FrancisCrickInstitute/Cryopup/README.md

# Cryopup

A low-cost device for cryoanaesthesia of neonate rodents that can cool and warm up.

CryoPup_graphical_abstract
