FrancisCrickInstitute/Cryopup/Manufacturing files/Printed circuit board/BOM_PCB_2021-06-22_17-24-27_2022-03-15.csv

ID | Name | Designator | Footprint | Quantity | Manufacturer Part | Manufacturer | Supplier | Supplier Part | Price | Pins | JLCPCB Part Class | LCSC Assembly | Contributor | SMT Type
1 | 1K | R18,R1 | R0805 | 2 | 0805W8F1001T5E | UniOhm | LCSC | C17513 | 0.002 | 2 | Basic Part |  | layout
2 | 10K | R21,R12,R13,R16 | R0805 | 4 | 0805W8F1002T5E | UniOhm | LCSC | C17414 | 0.002 | 2 | Basic Part |  | layout
3 | LTV-817S-TA1-C | U2 | OPTO-SMD-4_L4.6-W6.5-P2.54-LS10.3-BL | 1 | LTV-817S-TA1-C | LITEON | LCSC | C109227 | 0.072 | 4 | Extended Part |  | LCSC
4 | CON_HEADER_1X02-PTH | J1,J2,J3,J4 | M1X2 | 4 |  |  |  |  |  | 2 |  |  | DangerousPrototype
5 | micro USBFemale | USB1 | MICRO-USB-SMD_5P-P0.65-H-F_C10418 | 1 | micro USBFemale | ValuePro | LCSC | C10418 | 0.071 | 9 | Extended Part |  | 立创EDA官方封装库
6 | IRFH8318TRPBF | Q5,Q7,Q8,Q1,Q2 | PQFN-8_L5.8-W4.9-P1.27-LS6.0-BL-1 | 5 | IRFH8318TRPBF | Infineon | LCSC | C82059 | 0.562 | 9 | Extended Part |  | LCSC
7 | 3.9K | R8,R14 | R0805 | 2 | 0805W8F3901T5E | UniOhm | LCSC | C17614 | 0.002 | 2 | Basic Part |  | layout
8 | 1.8K | R17,R19,R20,R11,R15 | R0805 | 5 | 0805W8F1801T5E | UniOhm | LCSC | C17398 | 0.003 | 2 | Basic Part |  | layout
9 | DC005-2.0MM | DC1 | DC-IN-TH_DC005 | 1 | DC005-2.0MM | SOFNG | LCSC | C111567 | 0.153 | 3 |  |  | LCSC
10 | JUMPER-3PTH | JP1 | 1X03 | 1 |  |  |  |  |  | 3 |  |  | SparkFun
11 | 0.96OLED_4P | OLED1 | 0.96OLED_4P | 1 |  |  | LCSC |  |  | 4 |  |  | LCEDA_Lib
12 | PEC11R-4220F-S0012 | SW3 | SW-TH_PEC11R-4220F-S0012 | 1 | PEC11R-4220F-S0012 | BOURNS | LCSC | C143817 | 2.01 | 7 |  |  | LCSC
13 | 100nF | C1,C3,C8,C15 | C0805 | 4 | CC0805KRX7R9BB104 | YAGEO | LCSC | C49678 | 0.005 | 2 | Basic Part |  | LCSC
14 | 10uF | C2,C12,C14 | C0805 | 3 | CL21A106KAYNNNE | SAMSUNG | LCSC | C15850 |  | 2 | Basic Part |  | LCSC
15 | 10uF | C9,C16 | CAP-SMD_BD6.3-L6.6-W6.6-FD | 2 | EEEHB1H100SP | PANASONIC | LCSC | C178618 | 0.308 | 2 | Extended Part |  | LCSC
16 | 1uF | C10,C11,C13 | C0805 | 3 | CL21B105KBFNNNE | SAMSUNG | LCSC | C28323 | 0.009 | 2 | Basic Part |  | LCSC
17 | 22K | R9 | R0805 | 1 | 0805W8F2202T5E | UniOhm | LCSC | C17560 | 0.003 | 2 | Basic Part |  | layout
18 | 150 | R10 | R0805 | 1 | 0805W8F1500T5E | UniOhm | LCSC | C17471 | 0.003 | 2 |  | Yes | layout | Basic
19 | KF129R-5.0-2P | FET1,FET2,TC1,TC2,HB | CONN-TH_P5.00_KF129R-5.0-2P | 5 | KF129R-5.0-2P | Cixi Kefa Elec | LCSC | C475098 | 0.211 | 2 |  |  | LCSC
20 | SMALL_SERVO | SM | 1X03 | 1 |  |  |  |  |  | 3 |  |  | SparkFun
21 | NUP2105LT1G | D3 | SOT-23-3_L2.9-W1.6-P1.90-LS2.8-BR | 1 | NUP2105LT1G | ON | LCSC | C14486 | 0.396 | 3 |  | Yes | jiaowoxiaolu | Extend
22 | TS-1187A-B-A-B | SW2 | SW-SMD_4P-L5.1-W5.1-P3.70-LS6.5-TL-2 | 1 | TS-1187A-B-A-B | XKB Enterprise | LCSC | C318884 | 0.016 | 4 | Extended Part |  | LCSC
23 | 2.2uH | L2,L1,L4,L3 | L0805 | 4 | AIML-0805HC-2R2M-T | Abracon LLC | LCSC | C193676 | 0.243 | 2 |  |  | LCSC
24 | 470nF | C6 | C0805 | 1 | CL21B474KBFNNNE | SAMSUNG | LCSC | C13967 | 0.015 | 2 |  | Yes |  | Basic
25 | NUP2105LT1G | D1,D2 | SOT-23-3_L2.9-W1.6-P1.90-LS2.8-BR | 2 | NUP2105LT1G | ON | LCSC | C14486 | 0.396 | 3 |  | Yes |  | Extend
26 | 150 | R3,R2,R5,R7,R6,R4 | R0805 | 6 | 0805W8F1500T5E | UniOhm | LCSC | C17471 | 0.003 | 2 |  | Yes |  | Basic
27 | MAX31855KASA+T | U4,U9 | SO-8_L4.9-W3.9-P1.27-LS5.9-BL | 2 | MAX31855KASA+T | MAXIM | LCSC | C52028 | 5.215 | 8 |  | Yes |  | Extend
28 | 10nF | C7,C4 | C0805 | 2 | CL21B103KBANNNC | SAMSUNG | LCSC | C1710 | 0.006 | 2 |  | Yes |  | Basic
29 | CP2104-F03-GM | U11 | QFN-24_L4.0-W4.0-P0.50-BL-EP2.7 | 1 | CP2104-F03-GM | SILICON LABS | LCSC | C47742 | 4.179 | 25 | Basic Part
30 | Rocker switch601-10211BB | SW1 | SW-TH_601-10211BB | 1 | Rocker switch601-10211BB | BBJ | LCSC | C67849 | 0.177 | 3
31 | LED-0805_R | LED1 | LED0805_RED | 1 | 17-21SURC/S530-A3/TR8 | EVERLIGHT(台湾亿光) |  | C72037 | 0.017 | 2 |  |  | LCEDA_Lib
32 | L9958XP | U1 | POWERSSO-24_L10.5-W7.6-P0.80-LS10.5-BL | 1 | L9958XP | STMicroelectronics | LCSC | C443848 | 6.933 | 25 | Extended Part |  | LCSC
33 | AP7365-33WG-7 | U12 | SOT-25_L3.0-W1.6-P0.95-LS2.8-BR | 1 | AP7365-33WG-7 | DIODES | LCSC | C150742 | 0.208 | 5 | Extended Part |  | LCSC
34 | MMBT2222A-G | Q3,Q4 | SOT-23-3_L2.9-W1.6-P1.90-LS2.8-BR | 2 | MMBT2222A-G | CJ | LCSC | C164898 | 0.024 | 3 | Extended Part |  | LCSC
35 | ESP32-WROOM-32D(16MB) | U5 | WIFIM-SMD_39P-L25.5-W18.0-P1.27-BL | 1 | ESP32-WROOM-32D(16MB) | Espressif Systems | LCSC | C529578 | 4.764 | 39 | Extended Part |  | LCSC
36 | MC7805BDTRKG | U3 | TO-252-2_L6.6-W6.1-P4.57-LS9.9-TL-CW | 1 | MC7805BDTRKG | ON | LCSC | C110908 | 0.425 | 3 | Extended Part |  | 官方封装库
