FrancisCrickInstitute/Cryopup/Design files/Mechanical parts/Face holder.STEP

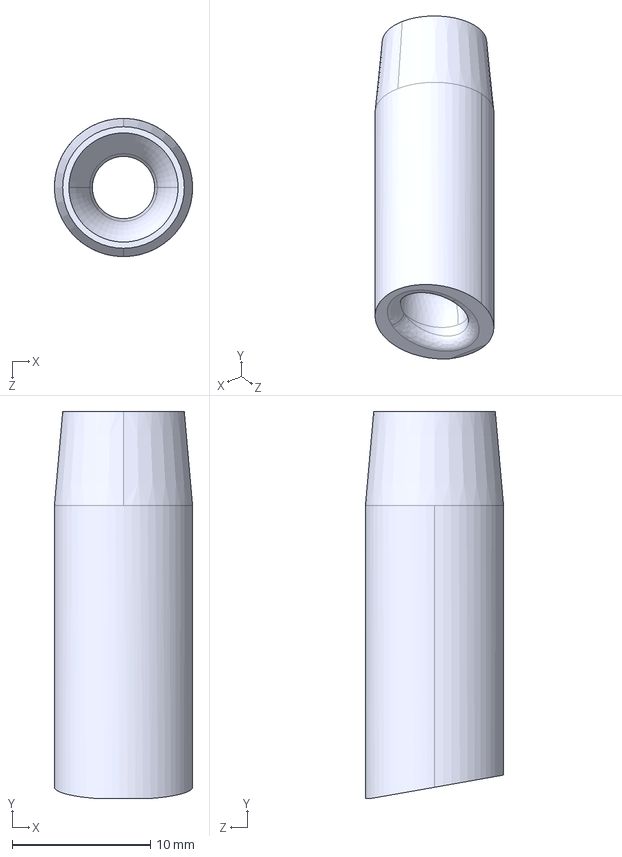
[picture p1: CAD file, 2022-05-17]
Design files/Mechanical parts/Face holder.STEP
10.00 x 28.0 x 10.00 mm
