FrancisCrickInstitute/Cryopup/Design files/Mechanical parts/Electronics holder.stp

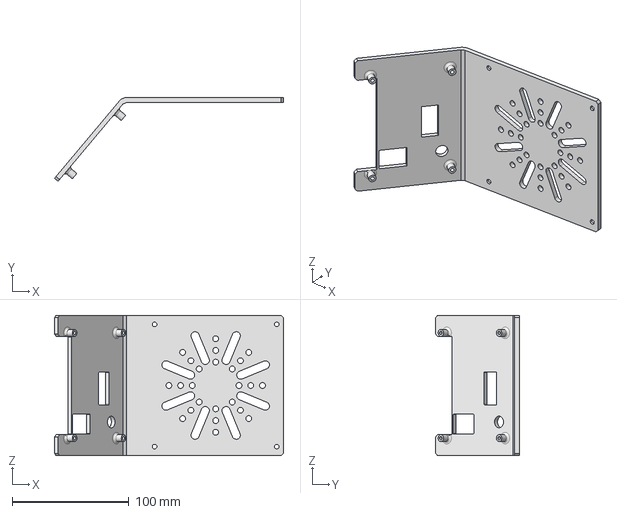
[picture p2: CAD file, 2022-05-13]
Design files/Mechanical parts/Electronics holder.stp
195.9 x 71.5 x 120.0 mm
