FrancisCrickInstitute/Cryopup/Manufacturing files/Mechanical parts/Base spacer.stl

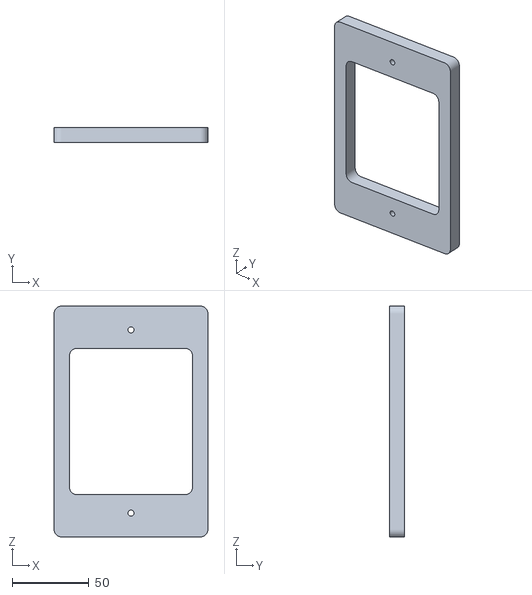
[picture p3: CAD file, 2022-05-13]
Manufacturing files/Mechanical parts/Base spacer.stl
100.0 x 10.0 x 150.0
