FrancisCrickInstitute/Cryopup/Design files/Mechanical parts/Base.stp

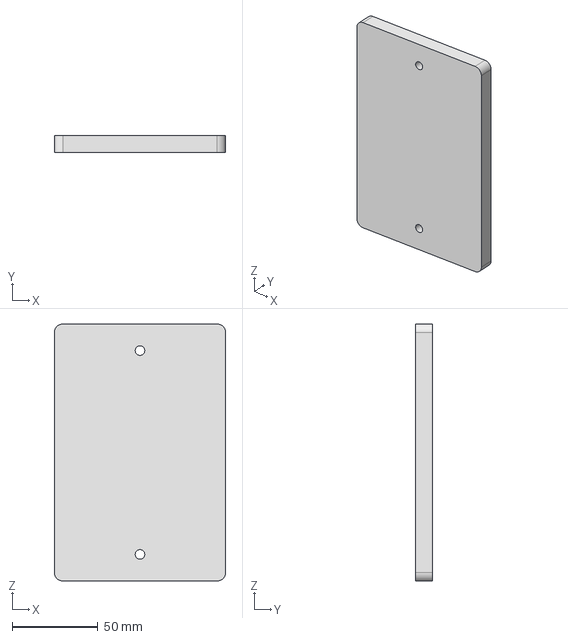
[picture p4: CAD file, 2022-05-13]
Design files/Mechanical parts/Base.stp
100.0 x 10.0 x 150.0 mm
