FrancisCrickInstitute/Cryopup/Design files/Mechanical parts/Peltier holder.stp

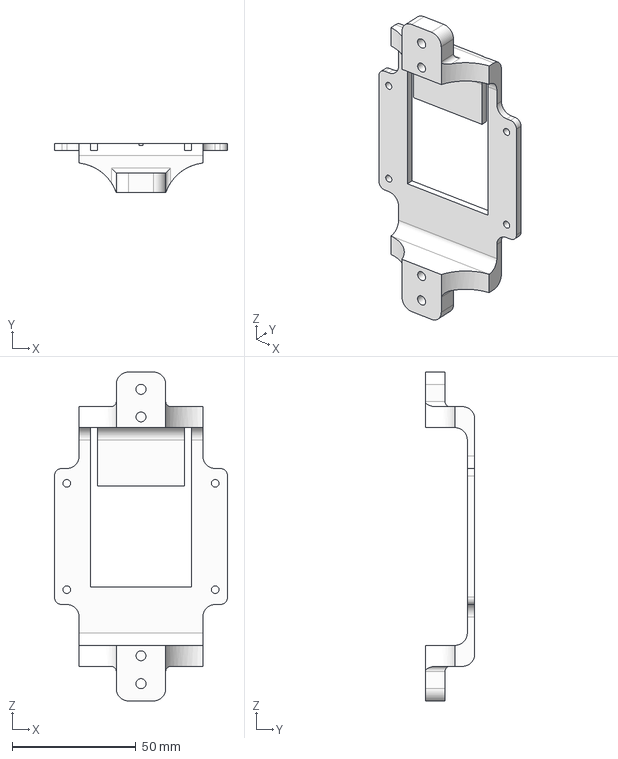
[picture p5: CAD file, 2022-05-13]
Design files/Mechanical parts/Peltier holder.stp
70.0 x 20.0 x 133.0 mm
