FrancisCrickInstitute/Cryopup/Manufacturing files/Mechanical parts/Bed.stp

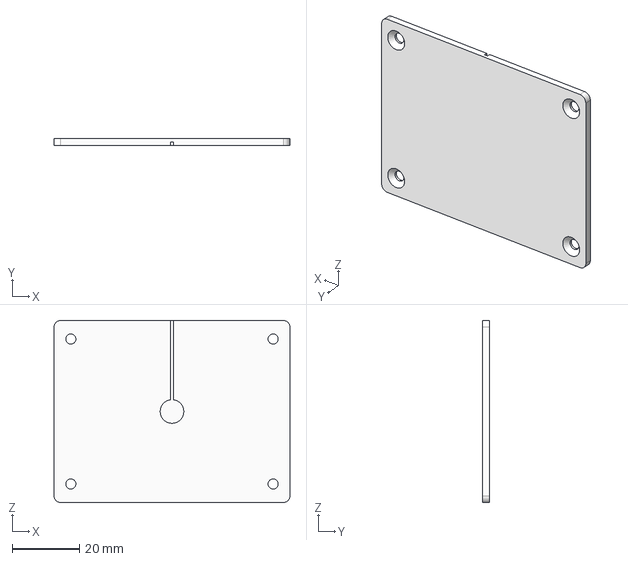
[picture p6: CAD file, 2022-05-13]
Manufacturing files/Mechanical parts/Bed.stp
70.0 x 2.00 x 54.0 mm
