FrancisCrickInstitute/Cryopup/Manufacturing files/Mechanical parts/Electronics holder.stl

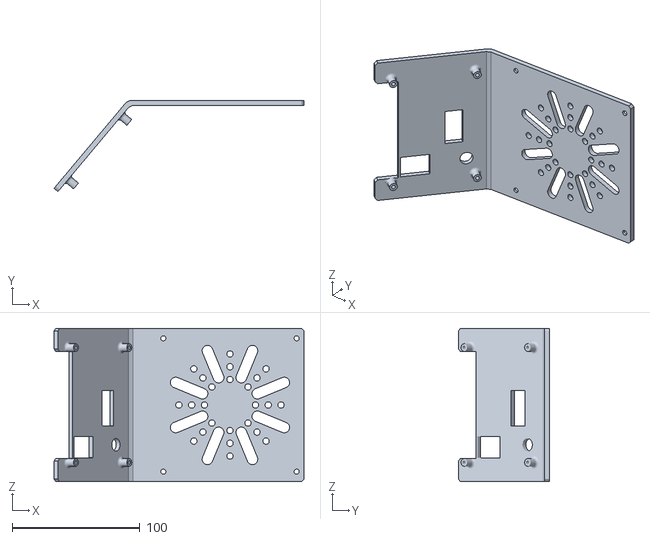
[picture p7: CAD file, 2021-12-07]
Manufacturing files/Mechanical parts/Electronics holder.stl
195.9 x 71.5 x 120.0
