FrancisCrickInstitute/Cryopup/(list of files, cad)

Other CAD files:
Manufacturing files/Mechanical parts/Face holder.STL
Manufacturing files/Mechanical parts/Base.stl
Design files/Mechanical parts/Bed.stp
Design files/Mechanical parts/Base spacer.stp
Manufacturing files/Mechanical parts/Peltier holder.stl
Design files/Mechanical parts/Base spacer.ipt
Design files/Mechanical parts/Base.ipt
Design files/Mechanical parts/Bed.ipt
Design files/Mechanical parts/Electronics holder.ipt
Design files/Mechanical parts/OldVersions/Base(4mm holes).0003.ipt
Design files/Mechanical parts/Peltier holder.ipt
Manufacturing files/Mechanical parts/Base spacer.dxf
Manufacturing files/Mechanical parts/Base.dxf
