FrancisCrickInstitute/Cryopup/Design files/Electronic board/Schematic_Cold_hot bed_2022-03-15.pdf

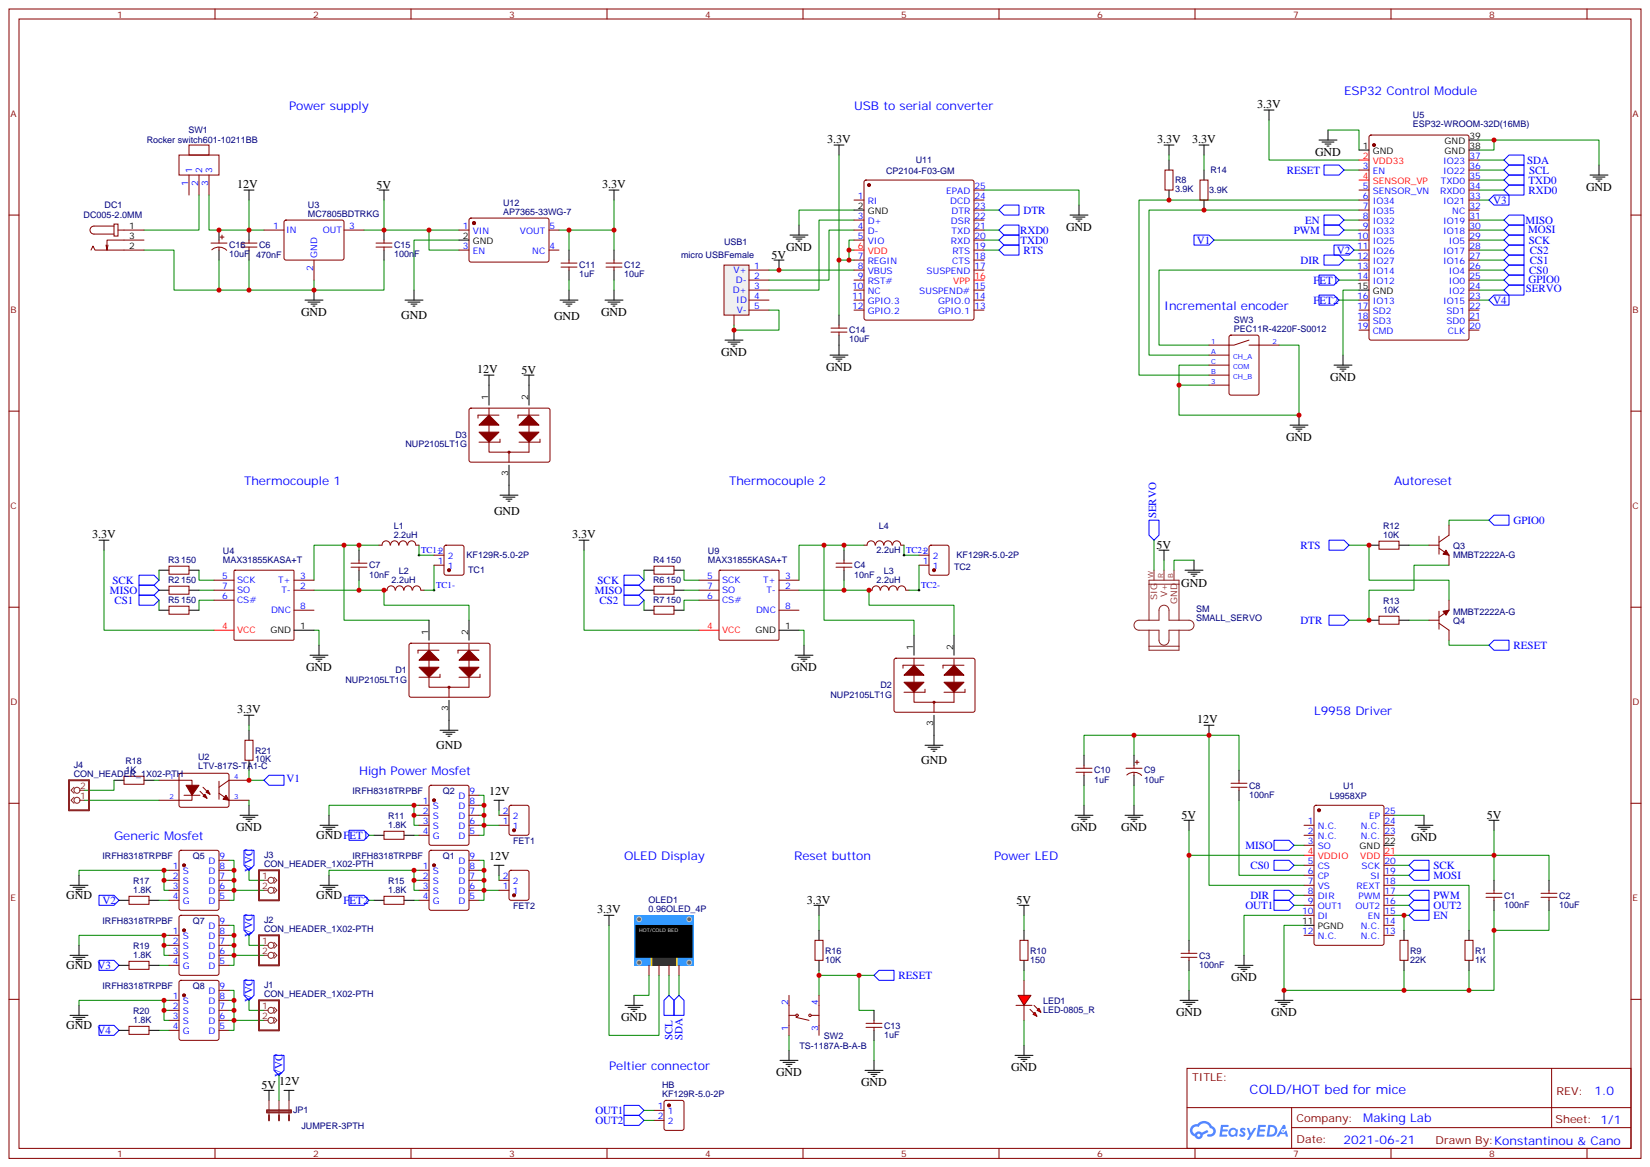
[picture p8: page 1]

USB to serial converter

Drawn By:Konstantinou & Cano
