FrancisCrickInstitute/Cryopup/(list of files, drawings)

Other design files:
Design files/Electronic board/PCB_PCB_2021-06-22_17-24-27_2022-03-15.json
Design files/Electronic board/SCH_Cold hot bed_2022-03-15.json
