FrancisCrickInstitute/Cryopup/Manufacturing files/Printed circuit board/PCB Ordering instructions.pdf

### PCB Ordering instructions:

Go to JLCPCB instant quote (https://cart.jlcpcb.com/quote?orderType=1&stencilLayer=2&stencilWidth=100&stencilLength=100&stencilCounts=5) and add Gerber file (Figure 1a).
Select default settings and preferred PCB color (Figure 1b).
Under PCB settings select SMT assembly and indicate quantity (2 or 5) (Figure 1c).

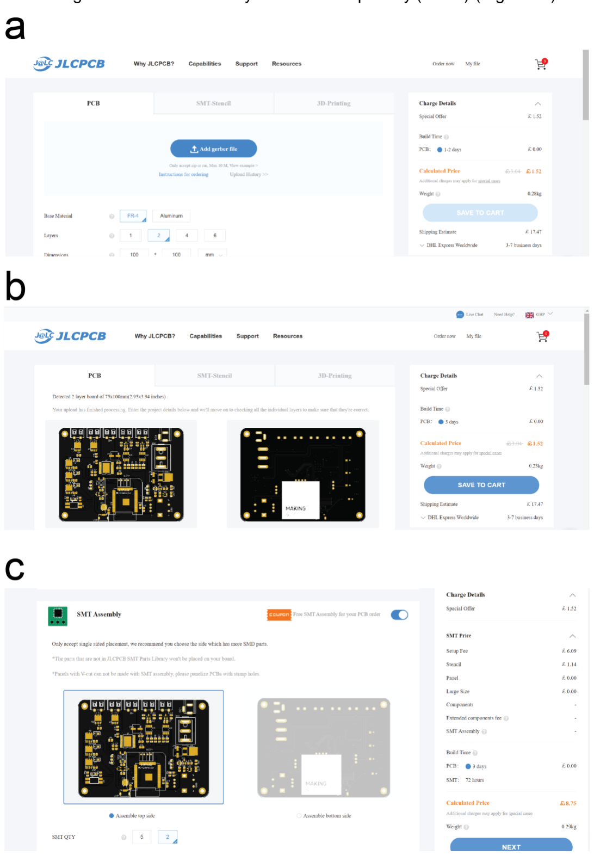
[picture p9: figure]

Figure 1

Click next and add the BOM and PnP files (Figure 2a-b).
Click next and review if any parts are unavailable. If yes, order from a different supplier (e.g. Mouser, Farnell, Digikey …). (Figure 2c).
Click next to see the position of each part on the PCB; save to cart and complete payment (Figure 3).

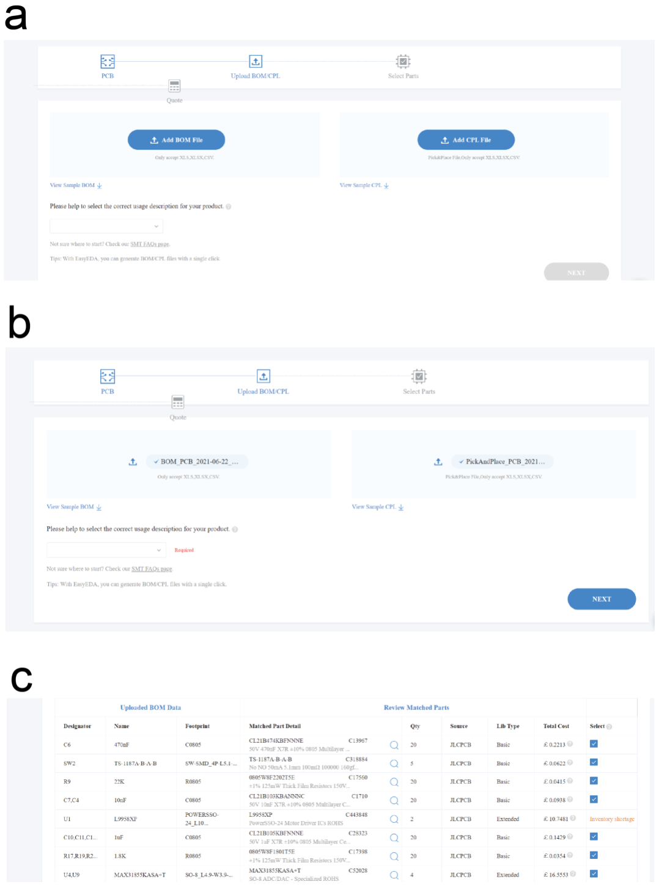
[picture p10: figure]

Figure 2

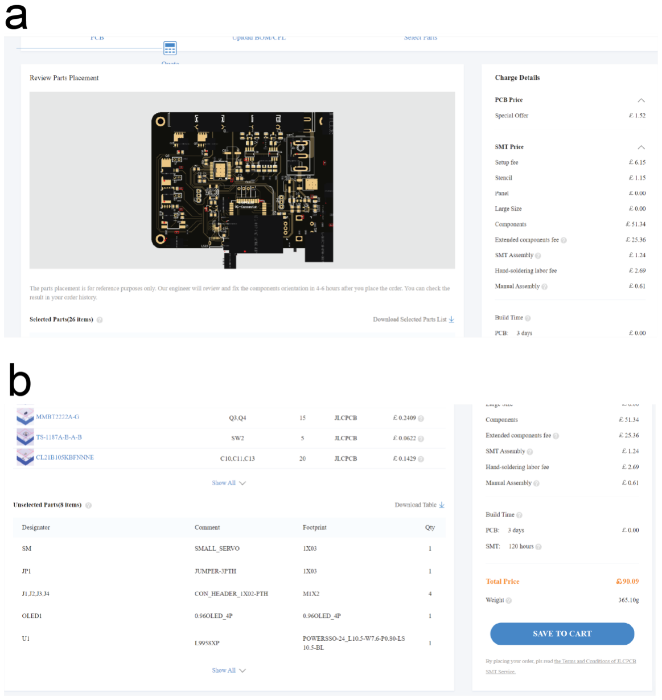
[picture p11: figure]

Figure 3
