FrancisCrickInstitute/Cryopup/(commit log)

2022-04-25 Main figure
    [Base spacer.dxf, Base spacer.ipt, Base(4mm holes).ipt, Bed.ipt, Coldhot bed response.xlsx]
2022-05-13 step files
    [Base spacer.stl, Base spacer.stp, Base.stl, Base.stp, Bed.stp, Electronics holder.stp, Peltier holder.stp]
2022-05-17 Face holder
    [Face holder.STEP, Face holder.STL]
2022-05-23 Firmware update
    [Coldhot bed response.xlsx]
2022-06-01 Create PCB Ordering instructions.pdf
